kevinfrei/ErgoBlue/(commit log)

2017-12-22 Soldered up the rows, and added some prose
2017-12-23 Seems like the left wired hardware is working: Software's another matter.
2017-12-23 Some cleanup, and swapping the rows & columns, because that's how I wired mine.
2018-01-07 Mostly wound back two commits, as the changes were more than I felt like debugging as a whole. Current stuff is smoke tested.
2018-01-07 Switched data being communicated to just a 5 byte matrix instead of scan codes.
2018-01-07 Updated battery level reporting across both halves
2018-01-07 Prose, because the code is at a reasonably decent stopping point (matrix/battery reading is good: no actual Bluetooth keyboard capabilities yet)
2018-01-10 Got the media control keys working! Play/Pause, Next/Prev Track, anyway...
2018-01-12 Added a simple text output capability, currently to dump the two keyboard's battery levels.
2018-01-12 Added better battery stuff, improved typing output a bit.
2018-01-16 Finished up the keymap, but I'm on an airplane, and won't be able to test for a couple days.
2018-01-16 Some minor docs to keep track of issues, because I'm on a plane, and I've never bothered using GitHub issues anyway...
2018-01-19 Getting elimination of the obnoxious Arduino build started
2018-01-22 Dropped Bluetooth power transmission quite a bit, raised the debounce count. Turned off DEBUG.
2018-01-29 Code comments, because I think I'm going to put this to bed for a while...
2018-02-01 A bit more file reorganization. It's kind of a disaster, now, but there is clearly structure that *wants* to be there. It just needs room to grow and spread it's wings...
